HaralDev/StappV2/GPSmodule.jpg

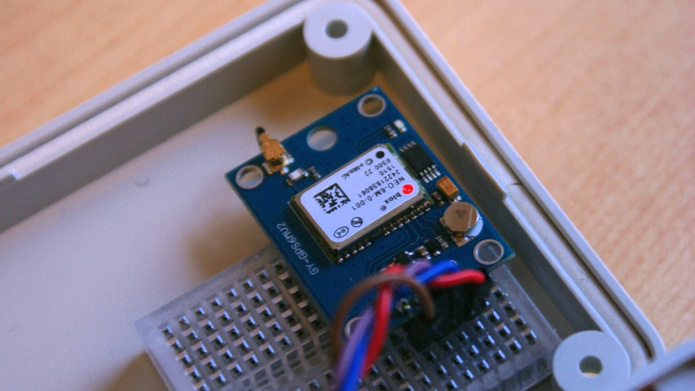
GPSmodule.jpg
